NazarDiadiun/Frequency-To-Voltage-Converter/Photos/photo_2021-05-15 18.44.31.jpeg

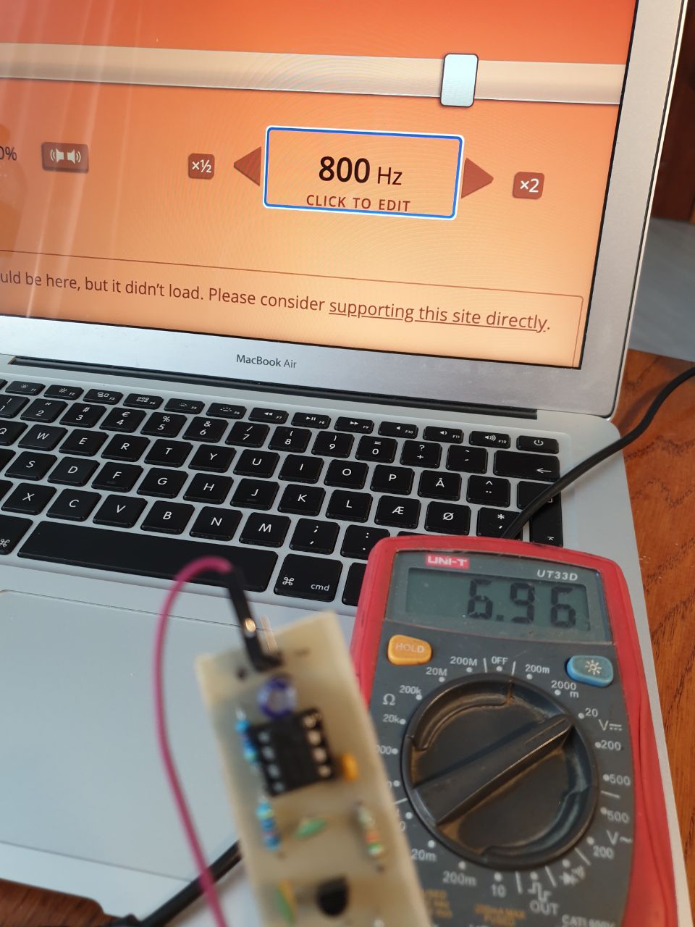
Photos/photo_2021-05-15 18.44.31.jpeg
