NazarDiadiun/Frequency-To-Voltage-Converter/README.md

Frequency To Voltage Converter based on NE555 Timer IC
