NazarDiadiun/Frequency-To-Voltage-Converter/3D Screenshots/Front.png

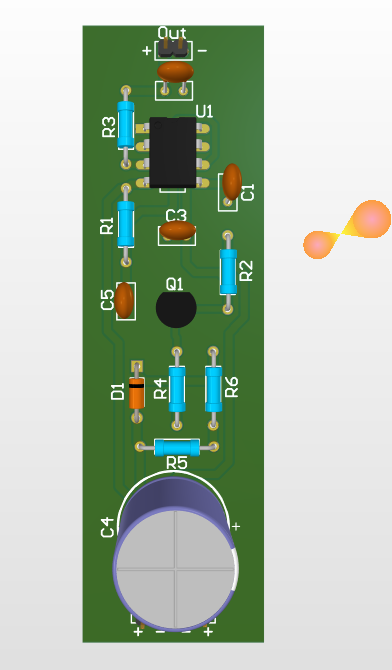
3D Screenshots/Front.png
