NazarDiadiun/Frequency-To-Voltage-Converter/3D Screenshots/Screenshot_1.png

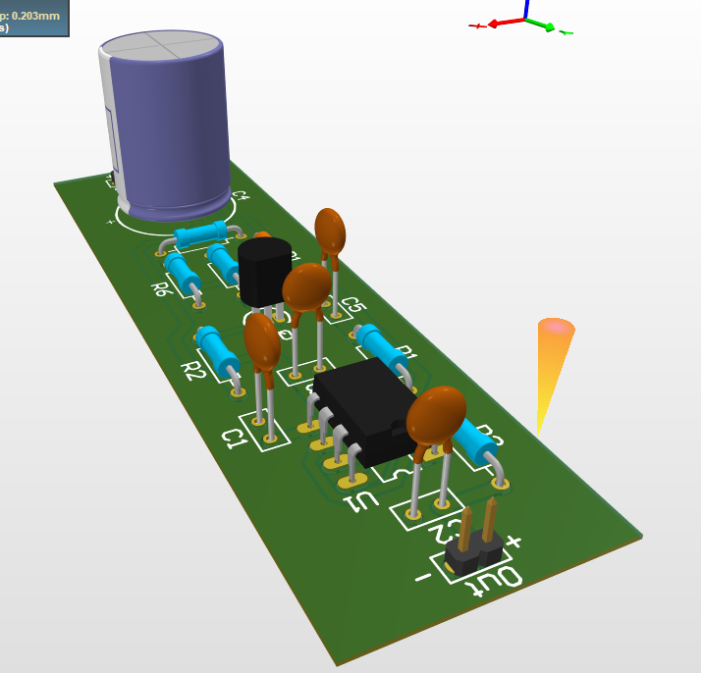
3D Screenshots/Screenshot_1.png
