NazarDiadiun/Frequency-To-Voltage-Converter/3D Screenshots/Screenshot_2.png

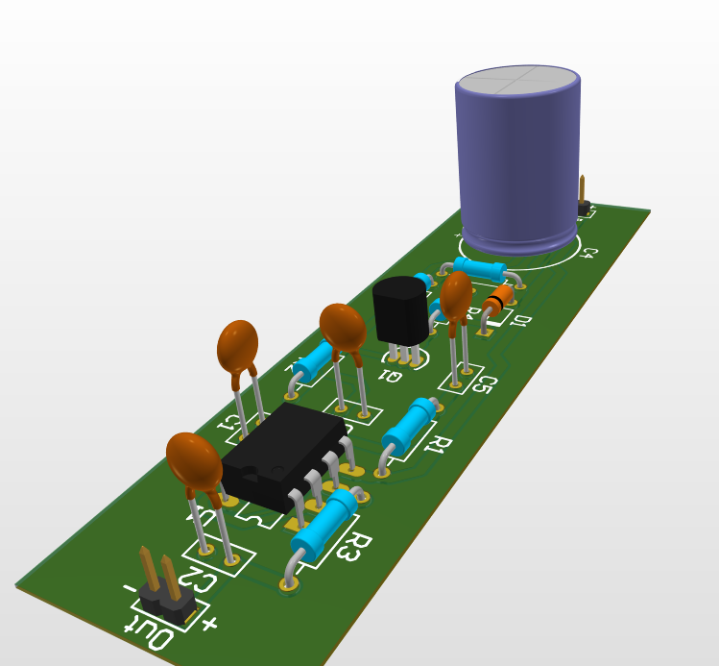
3D Screenshots/Screenshot_2.png
