NazarDiadiun/Frequency-To-Voltage-Converter/3D Screenshots/Screenshot_3.png

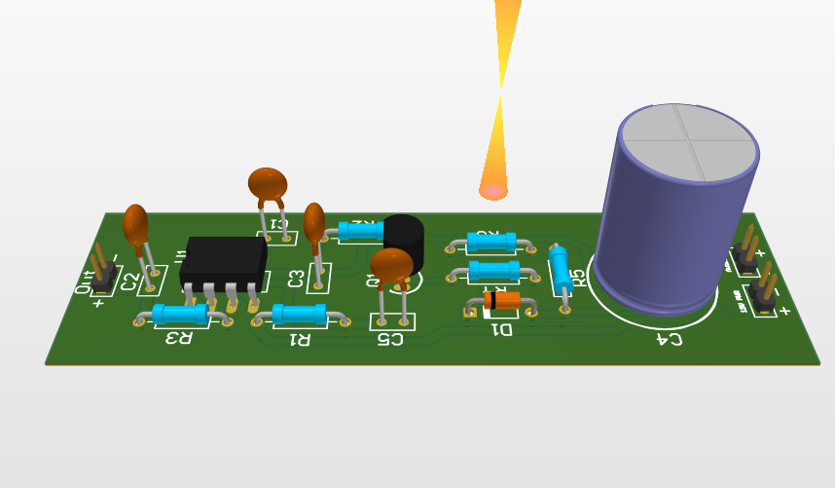
3D Screenshots/Screenshot_3.png
