NazarDiadiun/Frequency-To-Voltage-Converter/3D Screenshots/Screenshot_4.png

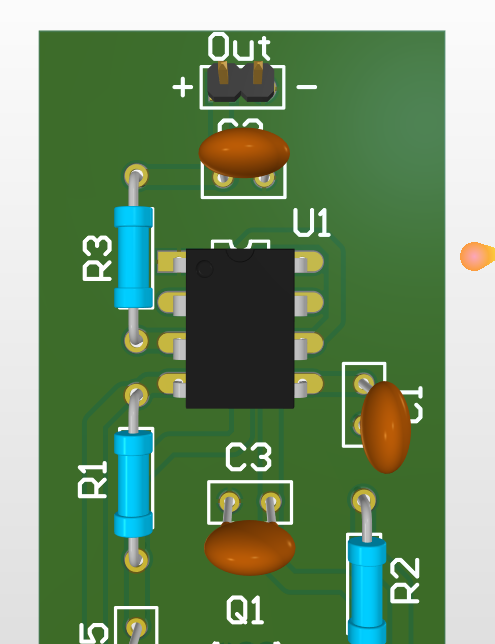
3D Screenshots/Screenshot_4.png
