NazarDiadiun/Frequency-To-Voltage-Converter/3D Screenshots/Screenshot_5.png

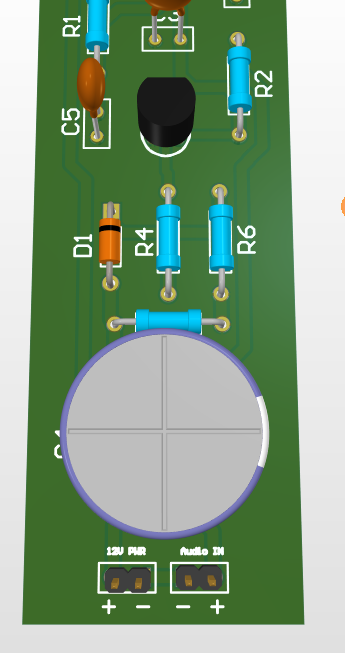
3D Screenshots/Screenshot_5.png
