NazarDiadiun/Frequency-To-Voltage-Converter/LT Spice/Input:CapCurrent 50Hz.png

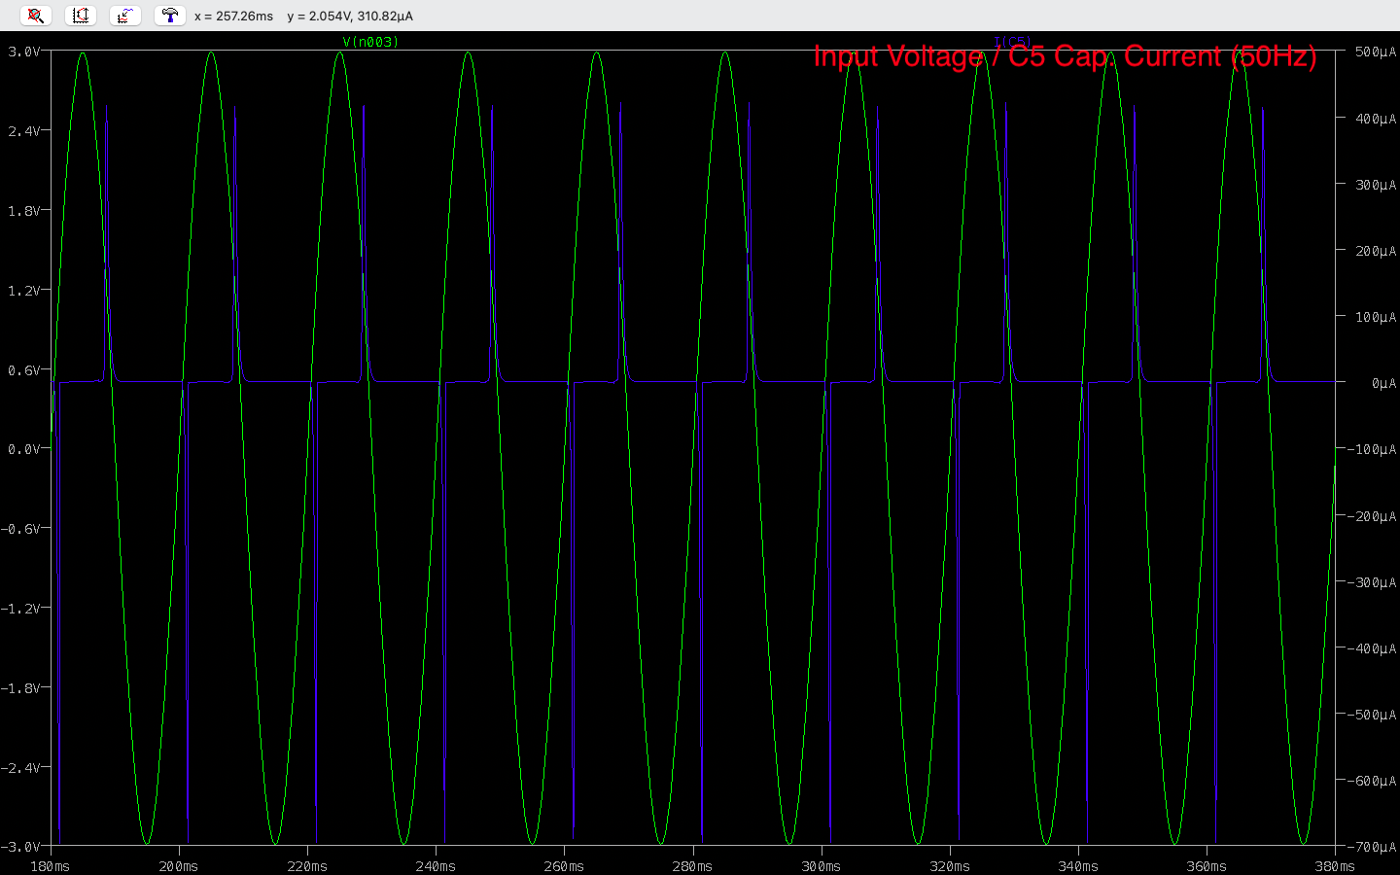
LT Spice/Input:CapCurrent 50Hz.png
