NazarDiadiun/Frequency-To-Voltage-Converter/LT Spice/Input:CapVoltage 50Hz.png

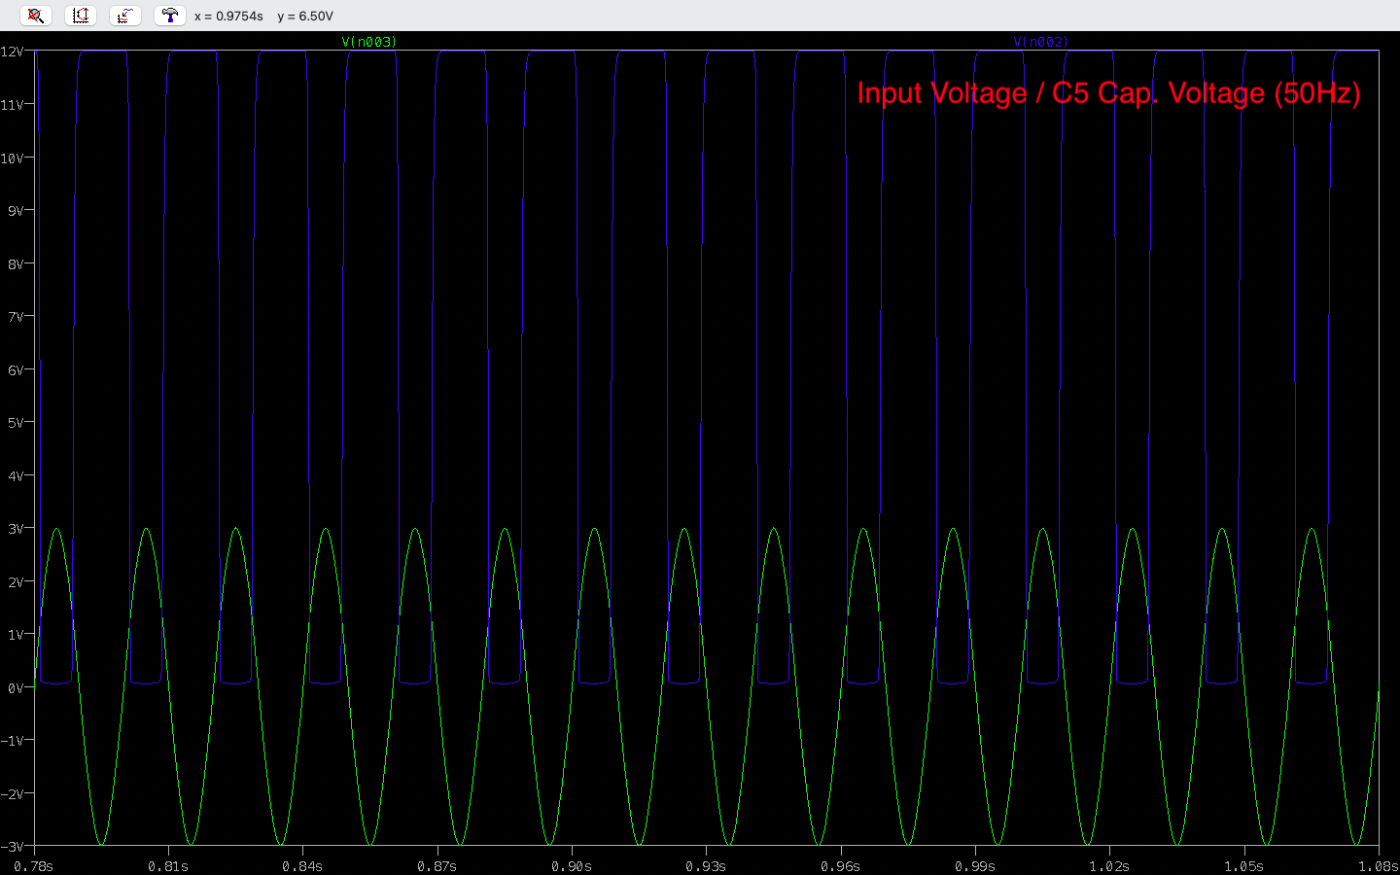
LT Spice/Input:CapVoltage 50Hz.png
