NazarDiadiun/Frequency-To-Voltage-Converter/LT Spice/Input:Output 50Hz.png

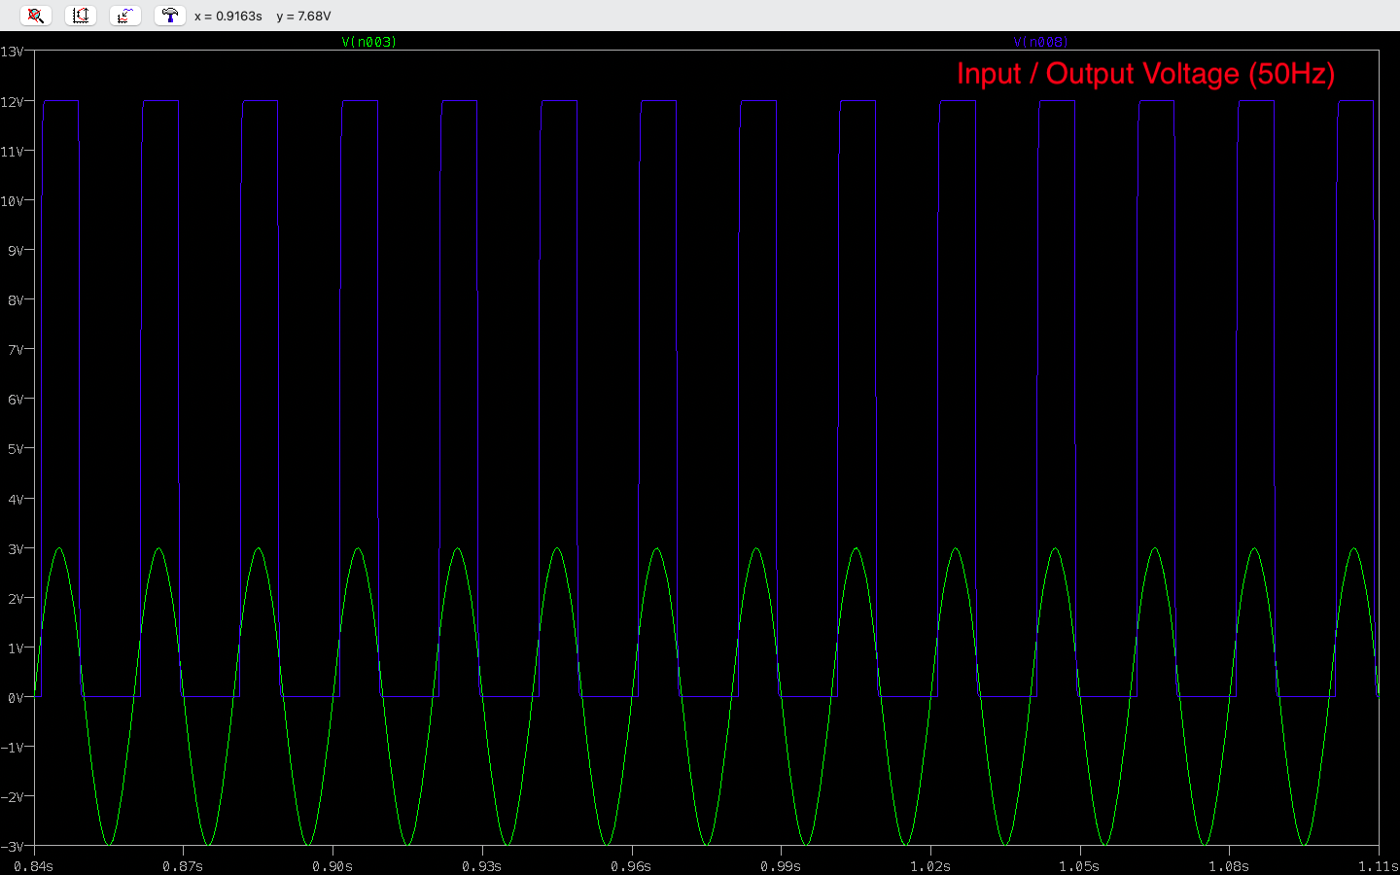
LT Spice/Input:Output 50Hz.png
