NazarDiadiun/Frequency-To-Voltage-Converter/LT Spice/Input:Output 360Hz.png

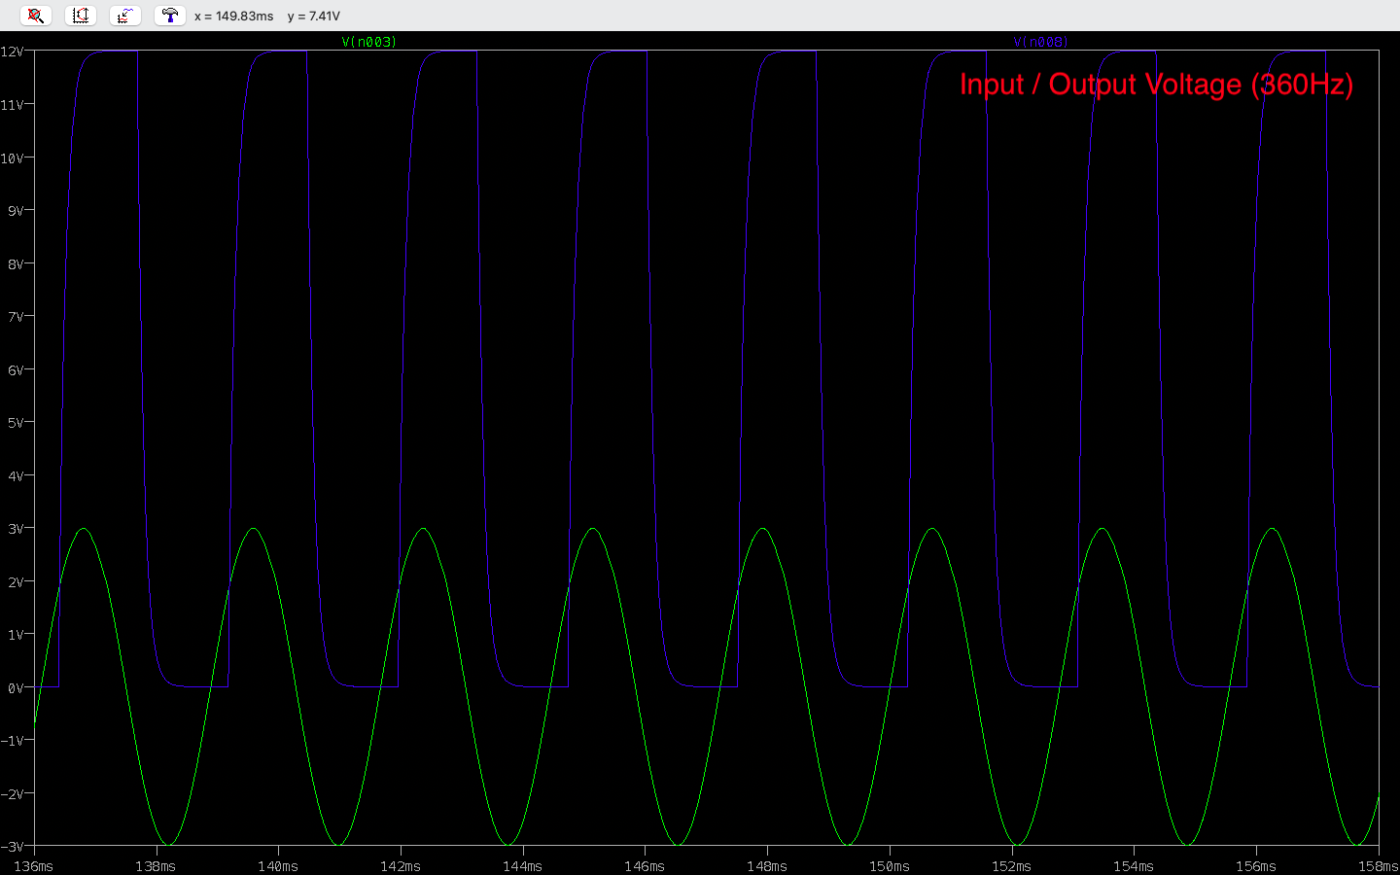
LT Spice/Input:Output 360Hz.png
