NazarDiadiun/Frequency-To-Voltage-Converter/LT Spice/Schematic.png

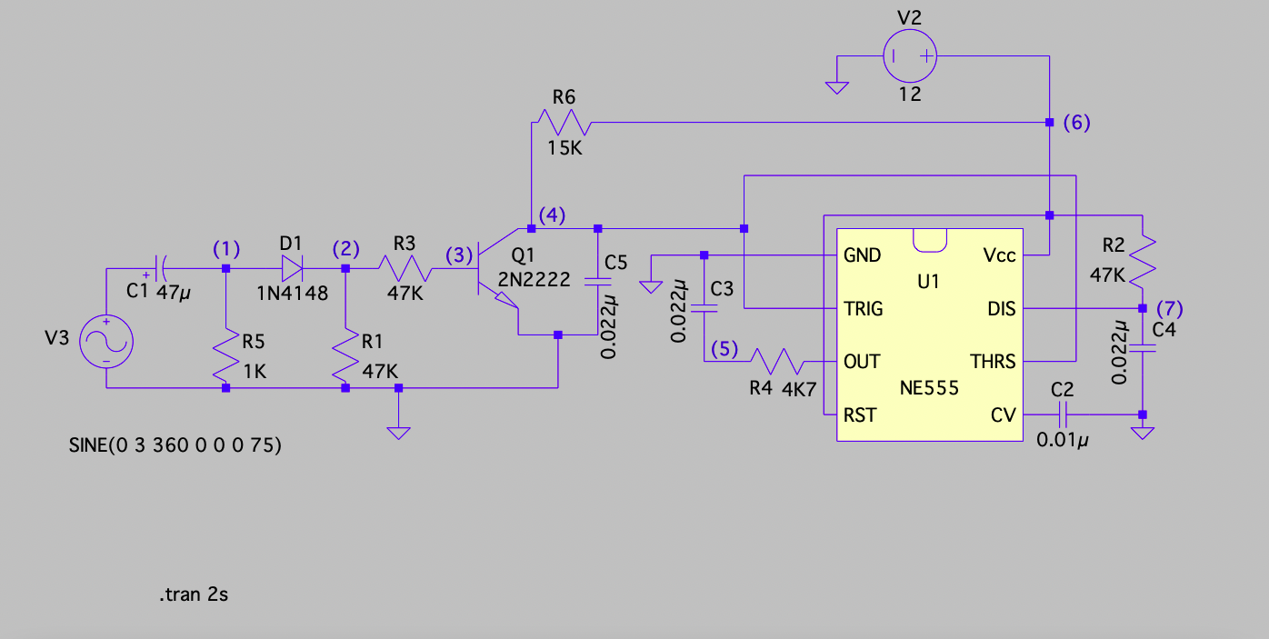
LT Spice/Schematic.png
