NazarDiadiun/Frequency-To-Voltage-Converter/Photos/photo_2021-05-15 18.44.27.jpeg

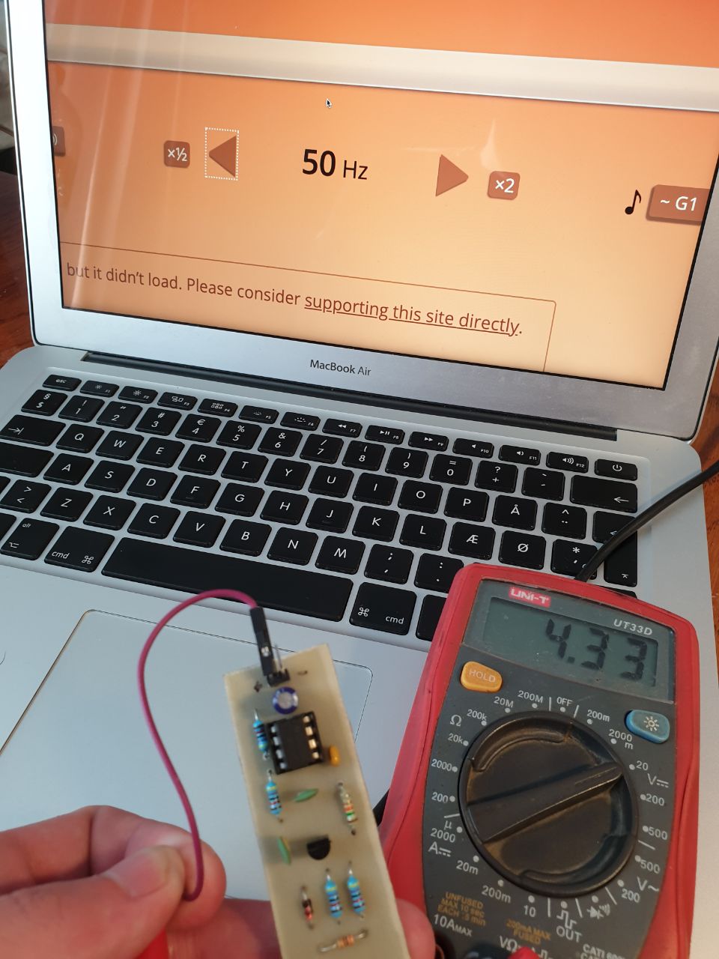
Photos/photo_2021-05-15 18.44.27.jpeg
