NazarDiadiun/Frequency-To-Voltage-Converter/Currents, Voltages & Components.xlsx

Element / node | Measured parameter | Value | Reference | Component Type | Parameters | Digikey Link
D1 | Current | 91.6 µA | D1 | Diode | 1N4148 (75V, 200mA) | https://www.digikey.com/en/products/detail/diotec/1N4148/12617729
R1 | Current | 52.8 µA | R1 | Resistor | 47K, 0.125W | https://www.digikey.com/en/products/detail/stackpole-electronics-inc/CF18JT47K0/1741721
R2 | Current | 264 µA | R2 | Resistor | 47K, 0.125W | https://www.digikey.com/en/products/detail/stackpole-electronics-inc/CF18JT47K0/1741721
R3 | Current | 39 µA | R3 | Resistor | 47K, 0.125W | https://www.digikey.com/en/products/detail/stackpole-electronics-inc/CF18JT47K0/1741721
R4 | Current | 250 µA | R4 | Resistor | 47K, 0.125W | https://www.digikey.com/en/products/detail/stackpole-electronics-inc/CF18JT47K0/1741721
R5 | Current | 3 mA | R5 | Resistor | 1K, 0.125W | https://www.digikey.com/en/products/detail/stackpole-electronics-inc/CF18JT1K00/1741612
R6 | Current | 795 µA | R6 | Resistor | 15K, 0.125W | https://www.digikey.com/en/products/detail/stackpole-electronics-inc/CF18JT15K0/1741594
C1 | Current | 3.05 mA | C1 | Electrolytic Capacitor | 47 µF, 16V | https://www.digikey.com/en/products/detail/nichicon/UPW1C470MDD1TD/4319934
C2 | Current | 19.5 fA | C2 | Capacitor | 0.01 µF, 25V | https://www.digikey.com/en/products/detail/kemet/C323C103K3G5TA/6656828
C3 | Current | 250 µA | C3 | Electrolytic Capacitor | 1 µF, 100V | https://www.digikey.com/en/products/detail/nichicon/UPW1C470MDD1TD/4319934
C4 | Current | 250 µA | C4 | Capacitor | 0.022 µF, 50V | https://www.digikey.com/en/products/detail/tdk-corporation/FG18X7R1H223KNT06/5811874
C5 | Current | 2.5 mA | C5 | Capacitor | 0.022 µF, 50V | https://www.digikey.com/en/products/detail/tdk-corporation/FG18X7R1H223KNT06/5811874
Q1 | Current (Base) | 39 µA | Q1 | Transistor | NPN, 2N2222 | https://www.digikey.com/en/products/detail/on-semiconductor/2N2222/33077
Q1 | Current (Collector) | 3.11 mA | U1 | IC | NE555 | https://www.digikey.com/en/products/detail/texas-instruments/NE555P/277057
Q1 | Current (Emmiter) | 3.11 mA
1 | Voltage | 2.96V
2 | Voltage | 2.49V
3 | Voltage | 0.685V
4 | Voltage | 11.92V
5 | Voltage | 11.99V
6 | Voltage | 12V
7 | Voltage | 8.53V
