NazarDiadiun/Frequency-To-Voltage-Converter/3D Models/BC337 3D Model.step

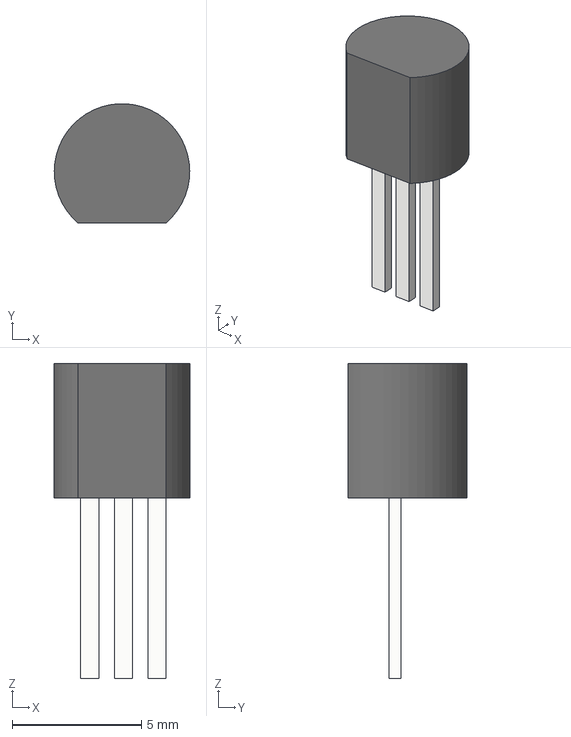
[picture p57: CAD file, 2021-05-15]
3D Models/BC337 3D Model.step
5.25 x 4.62 x 12.2 mm
