NazarDiadiun/Frequency-To-Voltage-Converter/Board 3D.step

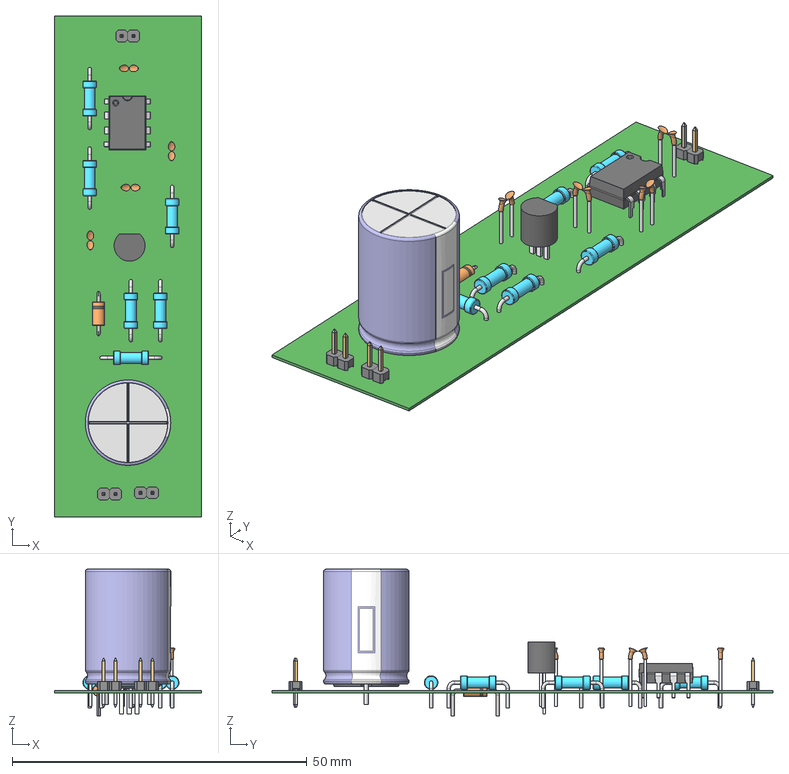
[picture p58: CAD file, 2021-05-15]
Board 3D.step
25.0 x 85.0 x 24.9 mm
Resistor_?1-4_horizontal_0.25W_10pitch x 6
Pin_Header_Male_1x32_MPE-Garry_150-1-001-0-S-XS0-0835 x 6
DIP8
BC337
1n4148
10pF_Ceramic_Disc_2 x 4
cap_el_vertical_d14.5_h20_p7.5_w0.8
