NazarDiadiun/Frequency-To-Voltage-Converter/3D Models/DIP8.STEP

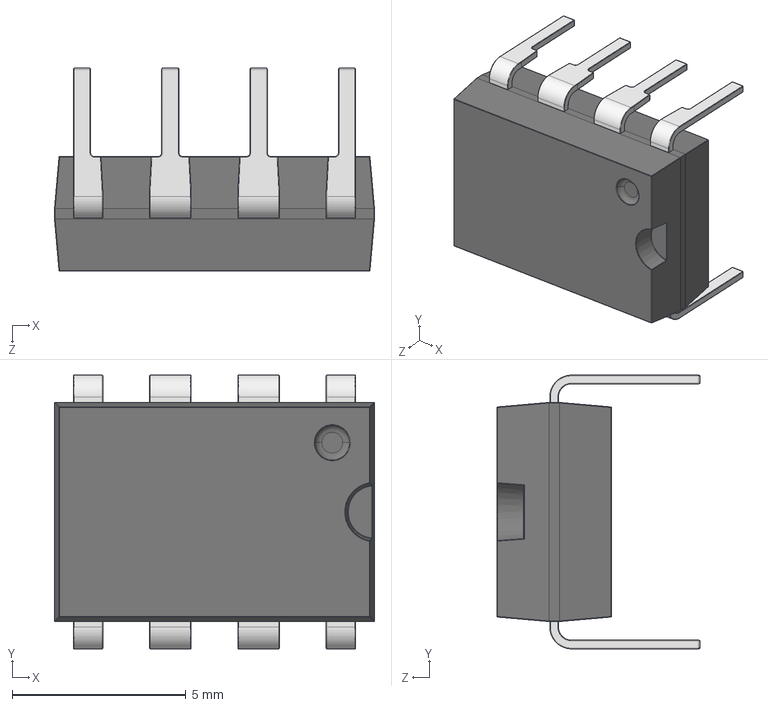
[picture p59: CAD file, 2021-05-15]
3D Models/DIP8.STEP
9.20 x 7.87 x 5.85 mm
