NazarDiadiun/Frequency-To-Voltage-Converter/(list of files, cad)

Other CAD files:
3D Models/BC337.f3d
