NazarDiadiun/Frequency-To-Voltage-Converter/Schematic.PDF

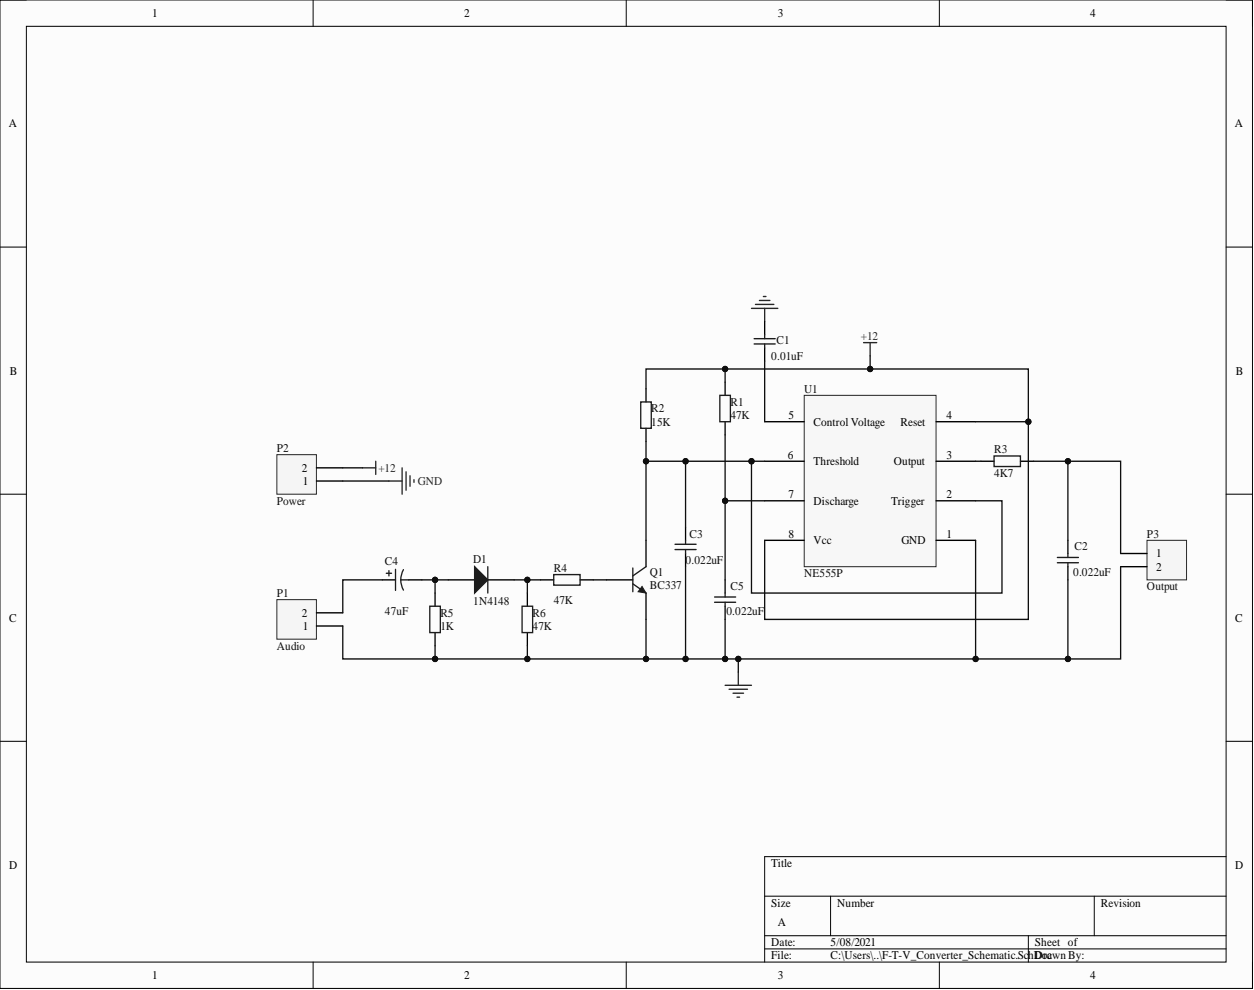
[picture p60: page 1]
