NazarDiadiun/Frequency-To-Voltage-Converter/PCB.pdf

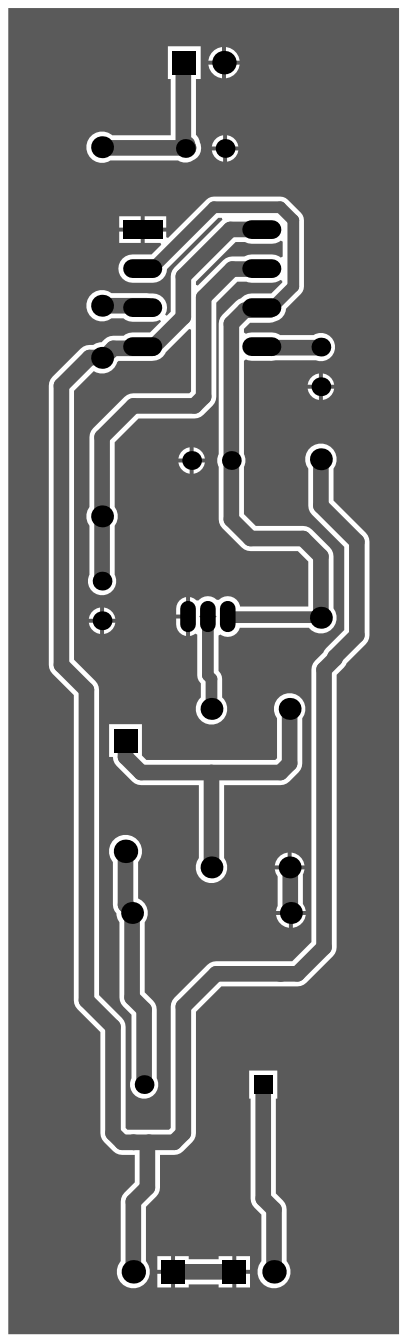
[picture p61: page 1]
