NazarDiadiun/Frequency-To-Voltage-Converter/LT Spice/Draft1.asc

C1: polcap; 47µ
C2: cap; 0.01µ
C3: polcap; 1µ
C4: cap; 0.022µ
C5: cap; 0.022µ
D1: diode; 1N4148
Q1: npn; BC337-40
R1: res; 47K
R2: res; 47K
R3: res; 10K
R4: res; 47k
R5: res; 1K
R6: res; 15K
U1: NE555
V2: voltage; 12
V3: signal; SINE(0 3 1000 0 0 0 4000)
Named nets: 0
.tran 1s
(1)
(2)
(3)
(4)
(5)
(6)
(7)
