NazarDiadiun/Frequency-To-Voltage-Converter/(list of files, drawings)

Other design files:
Altium Files/F-T-V Converter PCB.PcbDoc
Altium Files/F-T-V Converter.PrjPcb
Altium Files/F-T-V_Converter_Schematic.SchDoc
NE555 Timer Library/DIP8_Footprint.PcbLib
NE555 Timer Library/NE555_Schematic.SchLib
