NazarDiadiun/Frequency-To-Voltage-Converter/(commit log)

2021-05-15 Added All Current Files
    [BC337 3D Model.step, BC337.f3d, Board 3D.step, DIP8.STEP, DIP8_Footprint.PcbLib, F-T-V Converter PCB.PcbDoc, F-T-V Converter.PrjPcb, F-T-V_Converter_Schematic.SchDoc]
2021-05-15 Added LT Spice Files
    Project File, Schematic, Screenshots
    [Currents, Voltages & Components.xlsx]
2021-05-17 Updated .pdf, .docx files
    [Залежності напруги від частоти.xlsx]
